MarcusNolkrantz/Map-Robot-Project/README.md

# Kartroboten Columbus

Kod, dokument och annat relaterat till Grupp 5:s projekt i kursen 
*Konstruktion med mikrodatorer* (TSEA29) på Linköpings Tekniska Högskola.

## Medlemmar

- Mattias Ljung (matlj387)
- Felix Lindgren (felli675)
- Marcus Nolkrantz (marno874)
- Justus Karlsson (juska933)
- Edwin Johansson (edwjo109)
- Oskar Lundin (osklu414)

## Länkar

- [Kurssida](https://www.isy.liu.se/edu/kurs/TSEA29/)# Map-Robot-Project
