MarcusNolkrantz/Map-Robot-Project/pc/resources/empty_tile.png

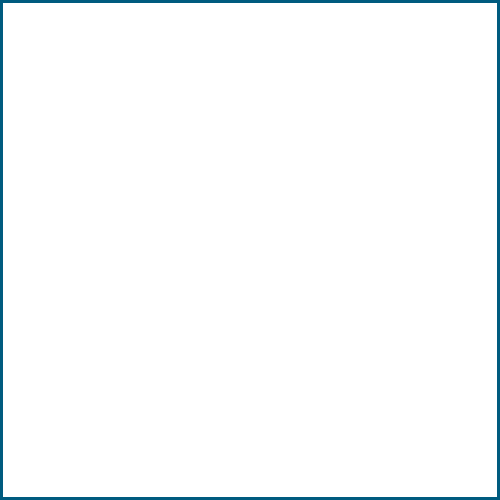
pc/resources/empty_tile.png
