MarcusNolkrantz/Map-Robot-Project/pc/resources/robot.png

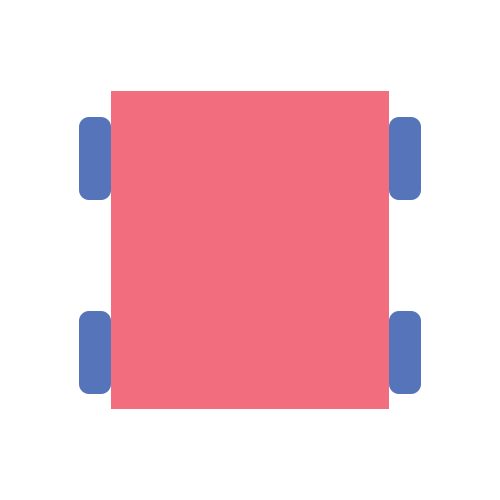
pc/resources/robot.png
