MarcusNolkrantz/Map-Robot-Project/pc/resources/wall_tile.png

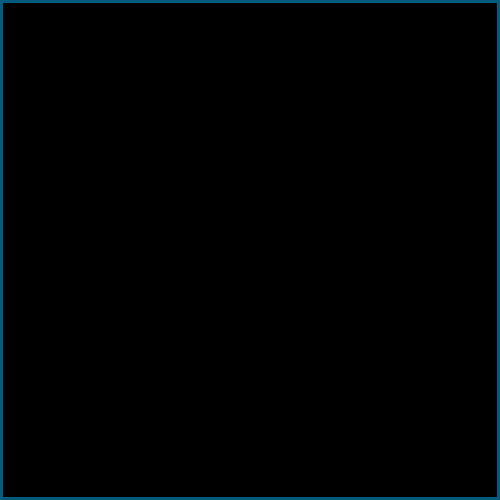
pc/resources/wall_tile.png
